copperhead143/OBD-Telemetry/firmware/README_DOC.jpeg

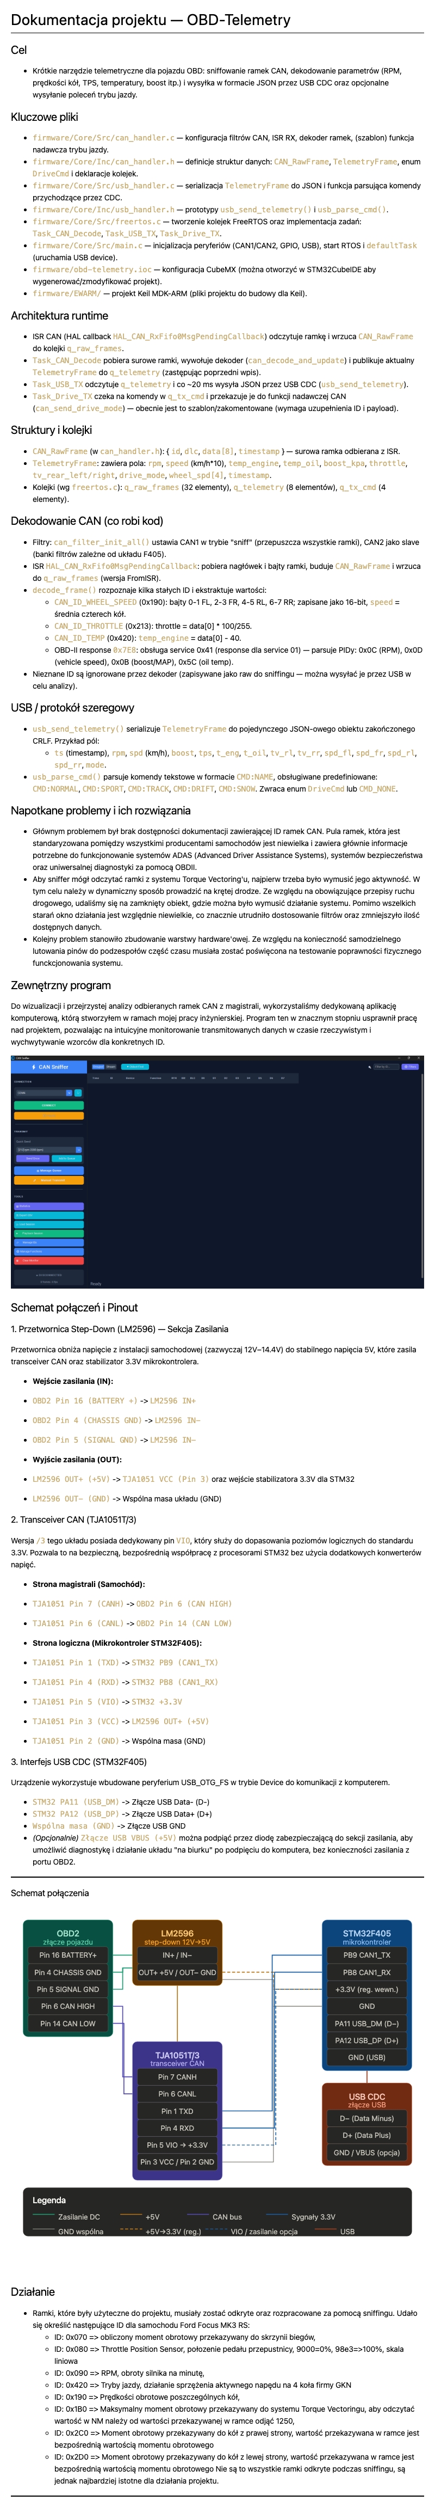
firmware/README_DOC.jpeg
