copperhead143/OBD-Telemetry/firmware/obd-telemetry.ioc

Mcu.UserName=STM32F405RGTx
PA11.Signal=USB_OTG_FS_DM
PA12.Signal=USB_OTG_FS_DP
PB12.Signal=CAN2_RX
PB13.Signal=CAN2_TX
PB8.Signal=CAN1_RX
PB9.Signal=CAN1_TX
PH0-OSC_IN.Signal=RCC_OSC_IN
PH1-OSC_OUT.Signal=RCC_OSC_OUT
