copperhead143/OBD-Telemetry/(commit log)

2026-04-09 feat add can led test
2026-05-09 feat add base CAN1 CAN2 filters
2026-05-09 feat add CAN frames and todo
2026-05-19 feat add TV frames IDs
